adafruit/Adafruit_Floppy_FeatherWing_PCB/Adafruit Floppy FeatherWing.brd

## EAGLE design Adafruit Floppy FeatherWing.brd (2023-02-21)

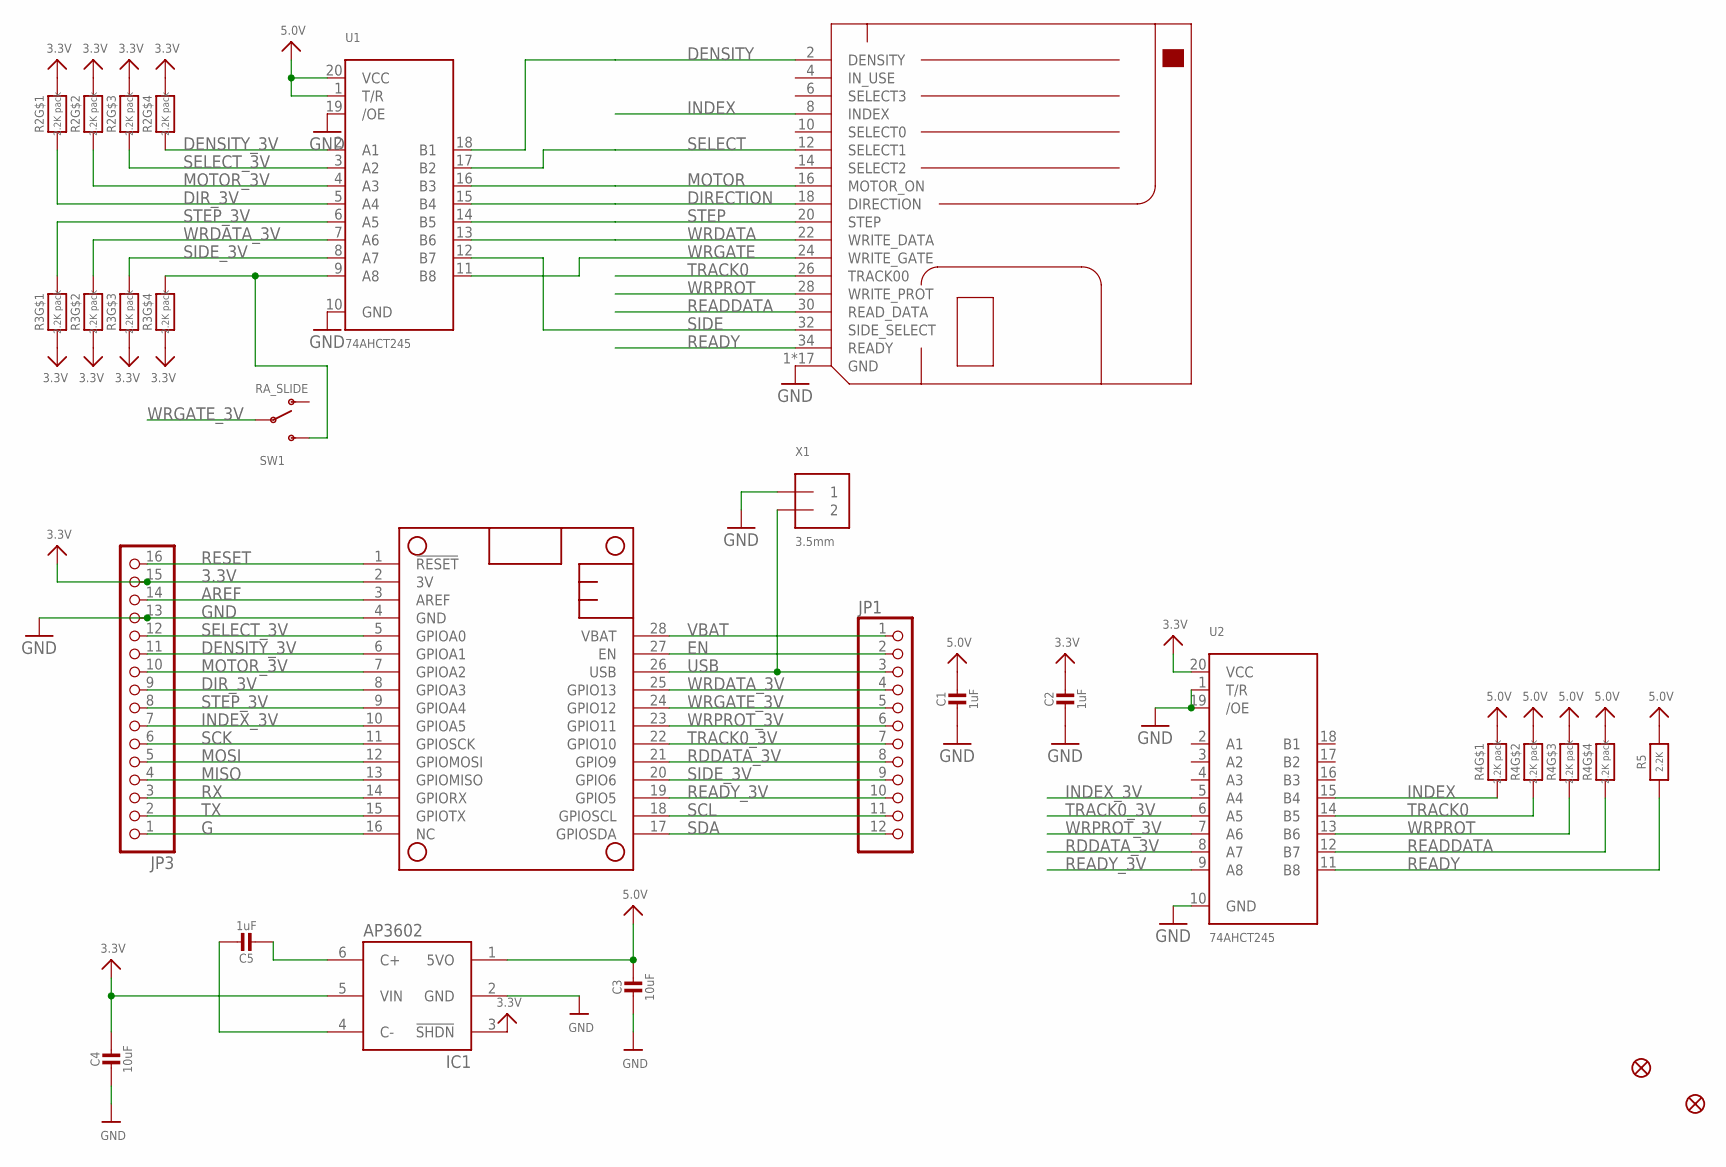
[picture p2: schematic Adafruit Floppy FeatherWing.sch]

Parts:
C1, C2, C5: 1uF; 0603-NO
C3, C4: 10uF; 0805-NO
FDD1: FLOPPY_IDC_SMT; 2X17_FLOPPY_SMTIDC
FID1, FID2: FIDUCIAL_1MM
IC1: AP3602; SOT23-6
JP1: HEADER-1X12; 1X12_ROUND
JP3: HEADER-1X16ROUND; 1X16_ROUND
MS1: FEATHERWING
R2, R3, R4: 2.2K pack; RESPACK_4X0603
R5: 2.2K; 0603-NO
SW1: RA_SLIDE; SPDT_SMT_SSSS811101
U1, U2: 74AHCT245; SSOP20
X1: 3.5mm; TERMBLOCK_1X2-3.5MM

Connections:
3.3V: C2.1, C4.1, IC1.3 (!SHDN), IC1.5 (VIN), JP3.15, MS1.2 (3V), R2.5 (2), R2.6 (2), R2.7 (2), R2.8 (2), R3.1, R3.2 (1), R3.3 (1), R3.4 (1), U2.20 (VCC)
5.0V: C1.1, C3.1, IC1.1 (5VO), R4.5 (2), R4.6 (2), R4.7 (2), R4.8 (2), R5.2, U1.1 (T/R), U1.20 (VCC)
AREF: JP3.14, MS1.3 (AREF)
DENSITY: FDD1.2 (DENSITY), U1.18 (B1)
DENSITY_3V: JP3.11, MS1.6 (GPIOA1), R2.4 (1), U1.2 (A1)
DIRECTION: FDD1.18 (DIRECTION), U1.15 (B4)
DIR_3V: JP3.9, MS1.8 (GPIOA3), R2.1, U1.5 (A4)
EN: JP1.2, MS1.27 (EN)
G: JP3.1, MS1.16 (NC)
GND: C1.2, C2.2, C3.2, C4.2, FDD1.1 (GND), FDD1.3 (GND), FDD1.5 (GND), FDD1.7 (GND), FDD1.9 (GND), FDD1.11 (GND), FDD1.13 (GND), FDD1.15 (GND), FDD1.17 (GND), FDD1.19 (GND), FDD1.21 (GND), FDD1.23 (GND), FDD1.25 (GND), FDD1.27 (GND), FDD1.29 (GND), FDD1.31 (GND), FDD1.33 (GND), IC1.2 (GND), JP3.13, MS1.4 (GND), U1.10 (GND), U1.19 (/OE), U2.1 (T/R), U2.10 (GND), U2.19 (/OE), X1.1
INDEX: FDD1.8 (INDEX), R4.1, U2.15 (B4)
INDEX_3V: JP3.7, MS1.10 (GPIOA5), U2.5 (A4)
MISO: JP3.4, MS1.13 (GPIOMISO)
MOSI: JP3.5, MS1.12 (GPIOMOSI)
MOTOR: FDD1.16 (MOTOR_ON), U1.16 (B3)
MOTOR_3V: JP3.10, MS1.7 (GPIOA2), R2.2 (1), U1.4 (A3)
unnamed: R3.5 (2), SW1.C (S), U1.9 (A8)
unnamed: C5.2, IC1.6 (C+)
unnamed: C5.1, IC1.4 (C-)
RDDATA_3V: JP1.8, MS1.21 (GPIO9), U2.8 (A7)
READDATA: FDD1.30 (READ_DATA), R4.4 (1), U2.12 (B7)
READY: FDD1.34 (READY), R5.1, U2.11 (B8)
READY_3V: JP1.10, MS1.19 (GPIO5), U2.9 (A8)
RESET: JP3.16, MS1.1 (!RESET)
RX: JP3.3, MS1.14 (GPIORX)
SCK: JP3.6, MS1.11 (GPIOSCK)
SCL: JP1.11, MS1.18 (GPIOSCL)
SDA: JP1.12, MS1.17 (GPIOSDA)
SELECT: FDD1.12 (SELECT1), U1.17 (B2)
SELECT_3V: JP3.12, MS1.5 (GPIOA0), R2.3 (1), U1.3 (A2)
SIDE: FDD1.32 (SIDE_SELECT), U1.12 (B7)
SIDE_3V: JP1.9, MS1.20 (GPIO6), R3.6 (2), U1.8 (A7)
STEP: FDD1.20 (STEP), U1.14 (B5)
STEP_3V: JP3.8, MS1.9 (GPIOA4), R3.8 (2), U1.6 (A5)
TRACK0: FDD1.26 (TRACK00), R4.2 (1), U2.14 (B5)
TRACK0_3V: JP1.7, MS1.22 (GPIO10), U2.6 (A5)
TX: JP3.2, MS1.15 (GPIOTX)
USB: JP1.3, MS1.26 (USB), X1.2
VBAT: JP1.1, MS1.28 (VBAT)
WRDATA: FDD1.22 (WRITE_DATA), U1.13 (B6)
WRDATA_3V: JP1.4, MS1.25 (GPIO13), R3.7 (2), U1.7 (A6)
WRGATE: FDD1.24 (WRITE_GATE), U1.11 (B8)
WRGATE_3V: JP1.5, MS1.24 (GPIO12), SW1.B
WRPROT: FDD1.28 (WRITE_PROT), R4.3 (1), U2.13 (B6)
WRPROT_3V: JP1.6, MS1.23 (GPIO11), U2.7 (A6)

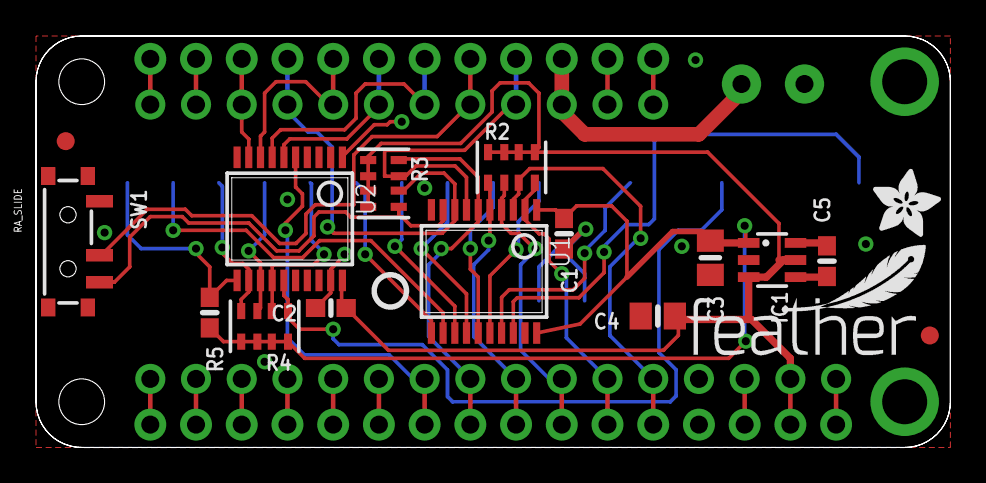
[picture p3: board Adafruit Floppy FeatherWing.brd from above]

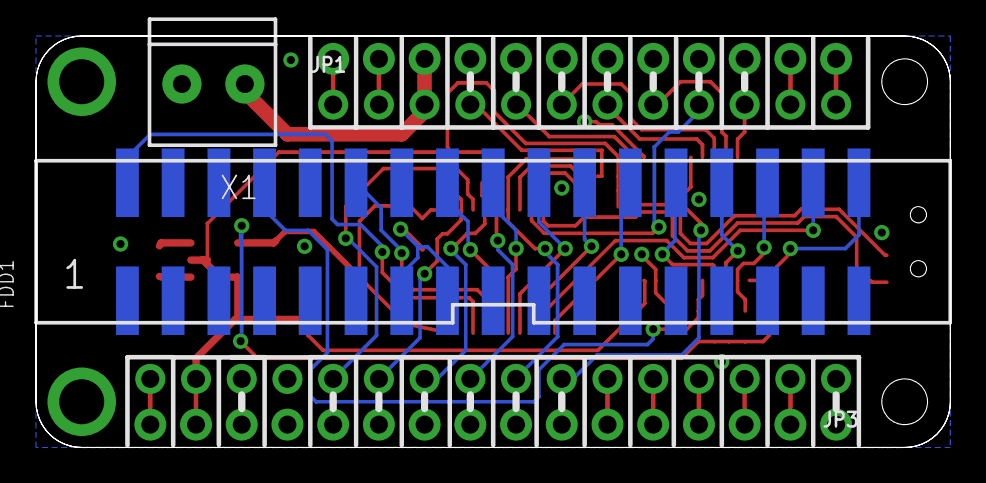
[picture p4: board Adafruit Floppy FeatherWing.brd from below]

Board: 2 copper layers, 50.8 x 22.9 mm, 59 parts (26 on the bottom side), 45 nets.

Other parts of the board:
PLABEL0: PLABEL0
PLABEL1: PLABEL1
PLABEL2: PLABEL2
PLABEL3: PLABEL3
PLABEL4: PLABEL4
PLABEL5: PLABEL5
PLABEL6: PLABEL6
PLABEL7: PLABEL7
PLABEL8: PLABEL8
PLABEL9: PLABEL9
PLABEL10: PLABEL10
PLABEL11: PLABEL11
PLABEL12: PLABEL12
PLABEL13: PLABEL13
PLABEL14: PLABEL14
PLABEL15: PLABEL15
PLABEL16: PLABEL16
PLABEL17: PLABEL17
PLABEL18: PLABEL18
PLABEL19: PLABEL19
PLABEL20: PLABEL20
PLABEL21: PLABEL21
PLABEL22: PLABEL22
PLABEL23: PLABEL23
PLABEL24: PLABEL24
PLABEL25: PLABEL25
PLABEL26: PLABEL26
PLABEL27: PLABEL27
PLABEL28: PLABEL28
PLABEL29: PLABEL29
PLABEL30: PLABEL30
PLABEL31: PLABEL31
PLABEL32: PLABEL32
PLABEL33: PLABEL33
PLABEL34: PLABEL34
PLABEL35: PLABEL35
U$26: PCBFEAT-REV-040
U$27: FEATHERLOGO_SMALL
U$28: ADAFRUIT_3.5MM
