adafruit/Adafruit_Floppy_FeatherWing_PCB/(threads)

Thread 1 (2024-10-06):

Adafruit Feather RP2040 Stuck In Bootsel if Drive is powered first.

v1605, 2024-10-06:
I'm seeing an issue where if the floppy drive (SonyMPF920-E, also sold by Adadruit) is powered first, the Pico will always enter bootsel mode. This seems like a hardware bug. Checked on both a Rev c and Rev d pico.
